RayL0707/Auto-Navigation-Robot-Design/flowchart/mainloop.png

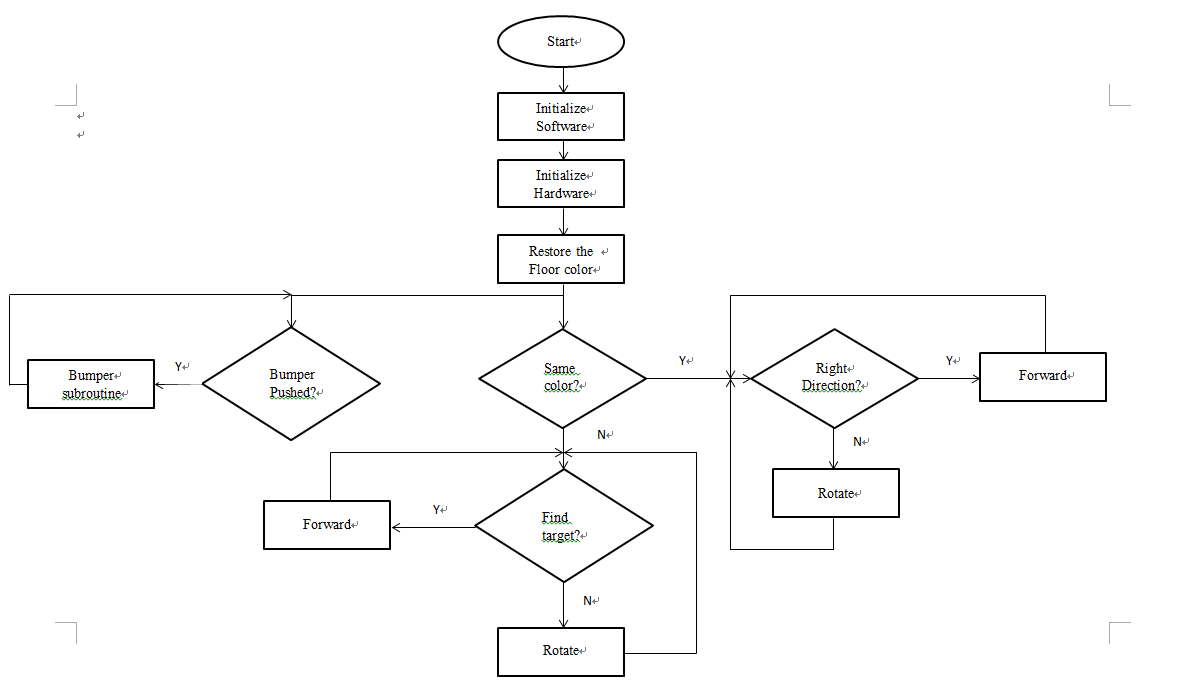
flowchart/mainloop.png
