RayL0707/Auto-Navigation-Robot-Design/bumper/Assem1.SLDASM

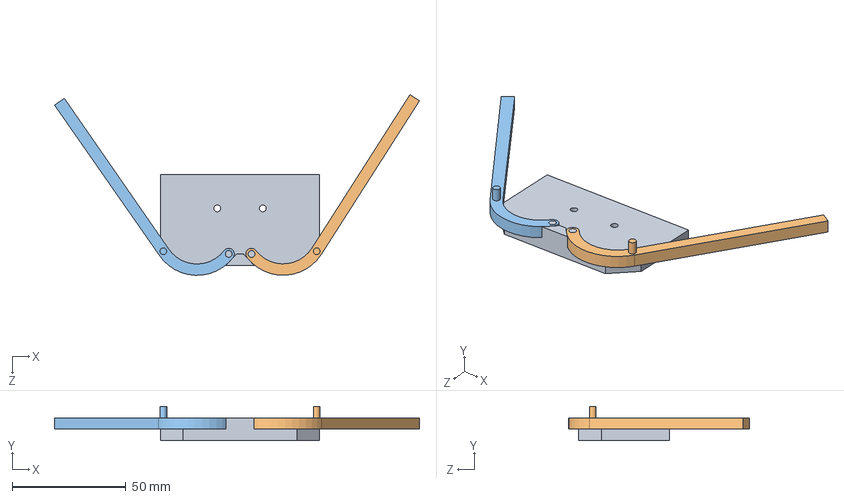
[picture p11: CAD file, 2017-01-19]
bumper/Assem1.SLDASM
160.3 x 15.0 x 79.4 mm
base
bumper1
bumper2
