RayL0707/Auto-Navigation-Robot-Design/bumper/base.SLDPRT

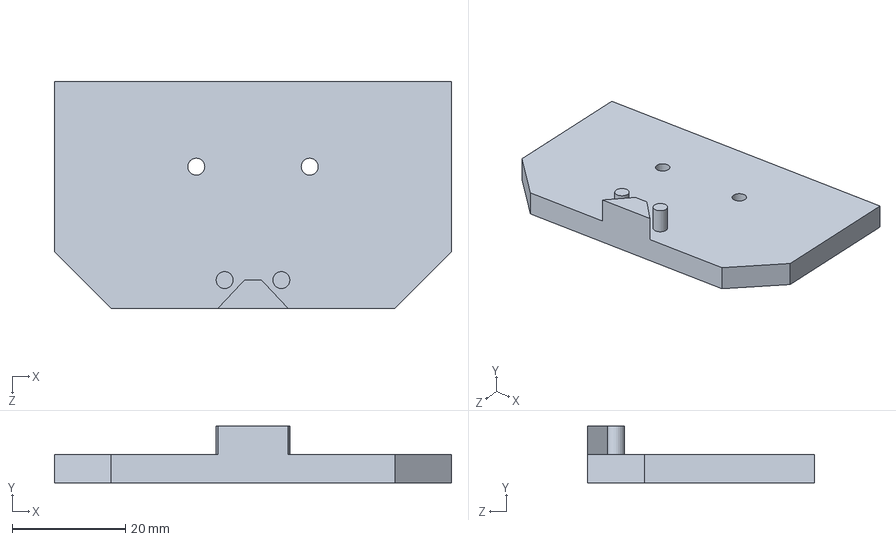
[picture p12: CAD file, 2017-01-19]
bumper/base.SLDPRT
70.0 x 10.0 x 40.0 mm
