RayL0707/Auto-Navigation-Robot-Design/bumper/bumper2.SLDPRT

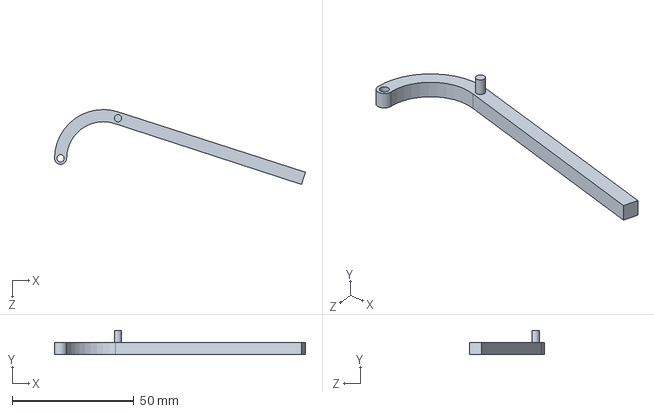
[picture p13: CAD file, 2017-01-19]
bumper/bumper2.SLDPRT
103.0 x 10.0 x 30.7 mm
