RayL0707/Auto-Navigation-Robot-Design/bumper/bumper3.SLDPRT

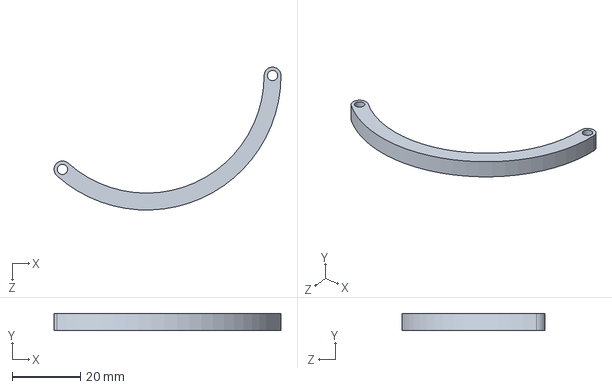
[picture p14: CAD file, 2017-01-19]
bumper/bumper3.SLDPRT
66.4 x 5.00 x 41.8 mm
