RayL0707/Auto-Navigation-Robot-Design/bumper/field.SLDPRT

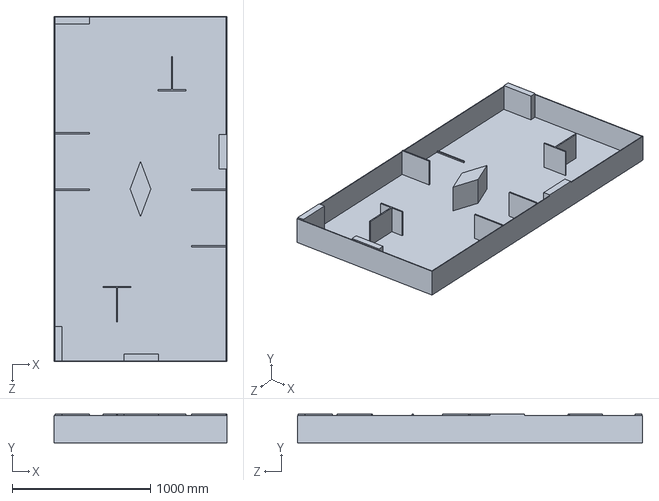
[picture p15: CAD file, 2017-01-19]
bumper/field.SLDPRT
1250.0 x 210.0 x 2500.0 mm
