RayL0707/Auto-Navigation-Robot-Design/bumper/bumper1.SLDPRT

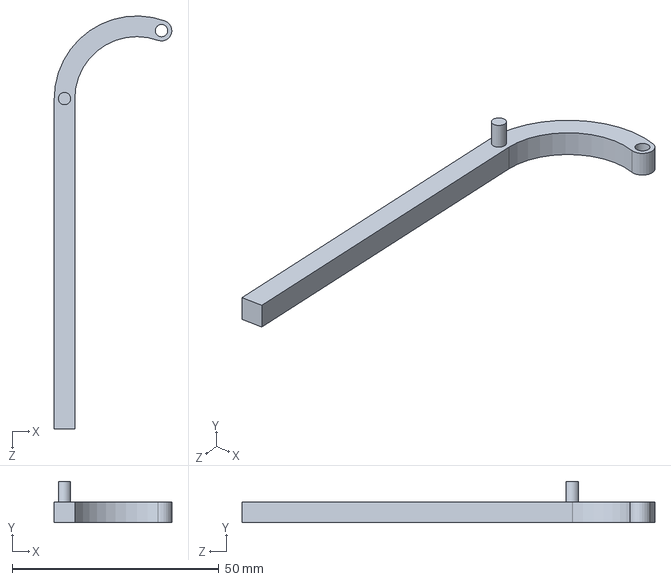
[picture p16: CAD file, 2017-01-19]
bumper/bumper1.SLDPRT
28.5 x 10.0 x 100.0 mm
