RayL0707/Auto-Navigation-Robot-Design/(list of files, cad)

Other CAD files:
design1robotcode/robot.X/dist/default/production/robot.X.production.obj
